dineshannayya/yifive_r0/signoff/glbl_cfg/final_summary_report.csv

 | design | design_name | config | flow_status | total_runtime | routed_runtime | (Cell/mm^2)/Core_Util | DIEAREA_mm^2 | CellPer_mm^2 | OpenDP_Util | Peak_Memory_Usage_MB | cell_count | tritonRoute_violations | Short_violations | MetSpc_violations | OffGrid_violations | MinHole_violations | Other_violations | Magic_violations | antenna_violations | lvs_total_errors | cvc_total_errors | klayout_violations | wire_length | vias | wns | pl_wns | optimized_wns | fastroute_wns | spef_wns | tns | pl_tns | optimized_tns | fastroute_tns | spef_tns | HPWL | routing_layer1_pct | routing_layer2_pct | routing_layer3_pct | routing_layer4_pct | routing_layer5_pct | routing_layer6_pct | wires_count | wire_bits | public_wires_count | public_wire_bits | memories_count | memory_bits | processes_count | cells_pre_abc | AND | DFF | NAND | NOR | OR | XOR | XNOR | MUX | inputs
0 | /project/openlane/glbl_cfg | glbl_cfg | glbl_cfg | flow_completed | 0h8m42s | -1 | 60666.66666666667 | 0.105 | 30333.333333333336 | 37.21 | 616.23 | 3185 | 0 | 0 | 0 | 0 | 0 | 0 | 0 | 1 | 0 | -1 | -1 | 218659 | 34566 | 0.0 | -0.95 | -1 | 0.0 | -1 | 0.0 | -482.9 | -1 | 0.0 | -1 | 130990511.0 | 0.6 | 52.03 | 38.6 | 16.27 | 0.76 | -1 | 1950 | 3987 | 521 | 2526 | 0 | 0 | 0 | 2136 | 0 | 0 | 0 | 0 | 0 | 0 | 0 | 4 | 772
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
