dineshannayya/yifive_r0/signoff/mbist/final_summary_report.csv

 | design | design_name | config | flow_status | total_runtime | routed_runtime | (Cell/mm^2)/Core_Util | DIEAREA_mm^2 | CellPer_mm^2 | OpenDP_Util | Peak_Memory_Usage_MB | cell_count | tritonRoute_violations | Short_violations | MetSpc_violations | OffGrid_violations | MinHole_violations | Other_violations | Magic_violations | antenna_violations | lvs_total_errors | cvc_total_errors | klayout_violations | wire_length | vias | wns | pl_wns | optimized_wns | fastroute_wns | spef_wns | tns | pl_tns | optimized_tns | fastroute_tns | spef_tns | HPWL | routing_layer1_pct | routing_layer2_pct | routing_layer3_pct | routing_layer4_pct | routing_layer5_pct | routing_layer6_pct | wires_count | wire_bits | public_wires_count | public_wire_bits | memories_count | memory_bits | processes_count | cells_pre_abc | AND | DFF | NAND | NOR | OR | XOR | XNOR | MUX | inputs
0 | /project/openlane/mbist | mbist_top | mbist | flow_completed | 0h11m7s | -1 | 20833.333333333336 | 0.3 | 10416.666666666668 | 13.1 | 672.64 | 3125 | 0 | 0 | 0 | 0 | 0 | 0 | 0 | 10 | 0 | 0 | -1 | 458568 | 43437 | -0.67 | -6.26 | -1 | -1.39 | -1 | -0.67 | -3033.14 | -1 | -1.39 | -1 | 372704250.0 | 1.47 | 48.85 | 12.24 | 20.92 | 0.0 | -1 | 2382 | 6613 | 753 | 4936 | 0 | 0 | 0 | 2339 | 0 | 0 | 0 | 0 | 0 | 0 | 0 | 4 | 849
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
