dineshannayya/yifive_r0/signoff/sdram/final_summary_report.csv

 | design | design_name | config | flow_status | total_runtime | routed_runtime | (Cell/mm^2)/Core_Util | DIEAREA_mm^2 | CellPer_mm^2 | OpenDP_Util | Peak_Memory_Usage_MB | cell_count | tritonRoute_violations | Short_violations | MetSpc_violations | OffGrid_violations | MinHole_violations | Other_violations | Magic_violations | antenna_violations | lvs_total_errors | cvc_total_errors | klayout_violations | wire_length | vias | wns | pl_wns | optimized_wns | fastroute_wns | spef_wns | tns | pl_tns | optimized_tns | fastroute_tns | spef_tns | HPWL | routing_layer1_pct | routing_layer2_pct | routing_layer3_pct | routing_layer4_pct | routing_layer5_pct | routing_layer6_pct | wires_count | wire_bits | public_wires_count | public_wire_bits | memories_count | memory_bits | processes_count | cells_pre_abc | AND | DFF | NAND | NOR | OR | XOR | XNOR | MUX | inputs
0 | /project/openlane/sdram | sdrc_top | sdram | flow_completed | 0h8m57s | -1 | 58833.33333333334 | 0.18 | 29416.66666666667 | 38.39 | 652.09 | 5295 | 0 | 0 | 0 | 0 | 0 | 0 | 0 | 1 | 0 | -1 | -1 | 264511 | 52608 | 0.0 | 0.0 | -1 | 0.0 | -1 | 0.0 | 0.0 | -1 | 0.0 | -1 | 181294869.0 | 11.7 | 40.27 | 30.17 | 2.01 | 0.34 | -1 | 3629 | 7296 | 841 | 4469 | 0 | 0 | 0 | 4426 | 0 | 0 | 0 | 0 | 0 | 0 | 0 | 4 | 1522
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
