dineshannayya/yifive_r0/signoff/spi_master/final_summary_report.csv

 | design | design_name | config | flow_status | total_runtime | routed_runtime | (Cell/mm^2)/Core_Util | DIEAREA_mm^2 | CellPer_mm^2 | OpenDP_Util | Peak_Memory_Usage_MB | cell_count | tritonRoute_violations | Short_violations | MetSpc_violations | OffGrid_violations | MinHole_violations | Other_violations | Magic_violations | antenna_violations | lvs_total_errors | cvc_total_errors | klayout_violations | wire_length | vias | wns | pl_wns | optimized_wns | fastroute_wns | spef_wns | tns | pl_tns | optimized_tns | fastroute_tns | spef_tns | HPWL | routing_layer1_pct | routing_layer2_pct | routing_layer3_pct | routing_layer4_pct | routing_layer5_pct | routing_layer6_pct | wires_count | wire_bits | public_wires_count | public_wire_bits | memories_count | memory_bits | processes_count | cells_pre_abc | AND | DFF | NAND | NOR | OR | XOR | XNOR | MUX | inputs
0 | /project/openlane/spi_master | spim_top | spi_master | flow_completed | 0h10m43s | -1 | 64763.63636363637 | 0.22 | 32381.818181818184 | 37.62 | 697.03 | 7124 | 0 | 0 | 0 | 0 | 0 | 0 | 0 | 1 | 0 | -1 | -1 | 300310 | 62802 | 0.0 | -4.46 | -1 | 0.0 | -1 | 0.0 | -1730.99 | -1 | 0.0 | -1 | 205930279.0 | 6.93 | 34.26 | 32.3 | 0.58 | 1.13 | -1 | 5865 | 8818 | 529 | 3481 | 0 | 0 | 0 | 6881 | 0 | 0 | 0 | 0 | 0 | 0 | 0 | 4 | 1764
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
