dineshannayya/yifive_r0/signoff/syntacore/final_summary_report.csv

 | design | design_name | config | flow_status | total_runtime | routed_runtime | (Cell/mm^2)/Core_Util | DIEAREA_mm^2 | CellPer_mm^2 | OpenDP_Util | Peak_Memory_Usage_MB | cell_count | tritonRoute_violations | Short_violations | MetSpc_violations | OffGrid_violations | MinHole_violations | Other_violations | Magic_violations | antenna_violations | lvs_total_errors | cvc_total_errors | klayout_violations | wire_length | vias | wns | pl_wns | optimized_wns | fastroute_wns | spef_wns | tns | pl_tns | optimized_tns | fastroute_tns | spef_tns | HPWL | routing_layer1_pct | routing_layer2_pct | routing_layer3_pct | routing_layer4_pct | routing_layer5_pct | routing_layer6_pct | wires_count | wire_bits | public_wires_count | public_wire_bits | memories_count | memory_bits | processes_count | cells_pre_abc | AND | DFF | NAND | NOR | OR | XOR | XNOR | MUX | inputs
0 | /project/openlane/syntacore | scr1_top_wb | syntacore | flow_completed | 0h50m54s | -1 | 53830.971659919036 | 0.7904 | 26915.485829959518 | 30.93 | 1194.42 | 21274 | 0 | -1 | -1 | -1 | -1 | 0 | -1 | 1 | 0 | -1 | -1 | 1674760 | 240681 | -2.04 | -17.8 | -1 | 0.0 | -1 | -2459.49 | -21655.63 | -1 | 0.0 | -1 | 1322263875.0 | 0.0 | 62.03 | 24.69 | 26.16 | 0.01 | -1 | 18597 | 30067 | 1067 | 12430 | 0 | 0 | 0 | 21980 | 0 | 0 | 0 | 0 | 0 | 0 | 0 | 4 | 5240
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
