dineshannayya/yifive_r0/signoff/uart_i2cm_usb/final_summary_report.csv

 | design | design_name | config | flow_status | total_runtime | routed_runtime | (Cell/mm^2)/Core_Util | DIEAREA_mm^2 | CellPer_mm^2 | OpenDP_Util | Peak_Memory_Usage_MB | cell_count | tritonRoute_violations | Short_violations | MetSpc_violations | OffGrid_violations | MinHole_violations | Other_violations | Magic_violations | antenna_violations | lvs_total_errors | cvc_total_errors | klayout_violations | wire_length | vias | wns | pl_wns | optimized_wns | fastroute_wns | spef_wns | tns | pl_tns | optimized_tns | fastroute_tns | spef_tns | HPWL | routing_layer1_pct | routing_layer2_pct | routing_layer3_pct | routing_layer4_pct | routing_layer5_pct | routing_layer6_pct | wires_count | wire_bits | public_wires_count | public_wire_bits | memories_count | memory_bits | processes_count | cells_pre_abc | AND | DFF | NAND | NOR | OR | XOR | XNOR | MUX | inputs
0 | /project/openlane/uart_i2cm_usb | uart_i2c_usb_top | uart_i2cm_usb | flow_completed | 0h14m13s | -1 | 74885.71428571428 | 0.28 | 37442.85714285714 | 43.47 | 782.88 | 10484 | 0 | 0 | 0 | 0 | 0 | 0 | 0 | 1 | 0 | -1 | -1 | 401689 | 90516 | -3.8 | -4.1 | -1 | -4.03 | -1 | -3.8 | -4.1 | -1 | -4.03 | -1 | 247493303.0 | 9.32 | 33.09 | 35.78 | 0.5 | 1.33 | -1 | 7738 | 11501 | 1123 | 4829 | 0 | 0 | 0 | 9082 | 0 | 0 | 0 | 0 | 0 | 0 | 0 | 4 | 2495
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
