dineshannayya/yifive_r0/signoff/user_project_wrapper/final_summary_report.csv

 | design | design_name | config | flow_status | total_runtime | routed_runtime | (Cell/mm^2)/Core_Util | DIEAREA_mm^2 | CellPer_mm^2 | OpenDP_Util | Peak_Memory_Usage_MB | cell_count | tritonRoute_violations | Short_violations | MetSpc_violations | OffGrid_violations | MinHole_violations | Other_violations | Magic_violations | antenna_violations | lvs_total_errors | cvc_total_errors | klayout_violations | wire_length | vias | wns | pl_wns | optimized_wns | fastroute_wns | spef_wns | tns | pl_tns | optimized_tns | fastroute_tns | spef_tns | HPWL | routing_layer1_pct | routing_layer2_pct | routing_layer3_pct | routing_layer4_pct | routing_layer5_pct | routing_layer6_pct | wires_count | wire_bits | public_wires_count | public_wire_bits | memories_count | memory_bits | processes_count | cells_pre_abc | AND | DFF | NAND | NOR | OR | XOR | XNOR | MUX | inputs
0 | /project/openlane/user_project_wrapper | user_project_wrapper | user_project_wrapper | flow_completed | 0h46m4s | -1 | 2.724159402241594 | 10.2784 | 1.362079701120797 | -1 | 534.94 | 14 | 0 | 0 | 0 | 0 | 0 | 0 | -1 | 0 | 0 | -1 | -1 | 1197869 | 8985 | 0.0 | -1 | -1 | 0.0 | -1 | 0.0 | -1 | -1 | 0.0 | -1 | -1 | 40144.17 | 3.22 | 3.61 | 0.52 | 0.31 | -1 | 248 | 2587 | 248 | 2587 | 0 | 0 | 0 | 14 | 0 | 0 | 0 | 0 | 0 | 0 | 0 | 0 | -1
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
