dineshannayya/yifive_r0/signoff/wb_host/final_summary_report.csv

 | design | design_name | config | flow_status | total_runtime | routed_runtime | (Cell/mm^2)/Core_Util | DIEAREA_mm^2 | CellPer_mm^2 | OpenDP_Util | Peak_Memory_Usage_MB | cell_count | tritonRoute_violations | Short_violations | MetSpc_violations | OffGrid_violations | MinHole_violations | Other_violations | Magic_violations | antenna_violations | lvs_total_errors | cvc_total_errors | klayout_violations | wire_length | vias | wns | pl_wns | optimized_wns | fastroute_wns | spef_wns | tns | pl_tns | optimized_tns | fastroute_tns | spef_tns | HPWL | routing_layer1_pct | routing_layer2_pct | routing_layer3_pct | routing_layer4_pct | routing_layer5_pct | routing_layer6_pct | wires_count | wire_bits | public_wires_count | public_wire_bits | memories_count | memory_bits | processes_count | cells_pre_abc | AND | DFF | NAND | NOR | OR | XOR | XNOR | MUX | inputs
0 | /project/openlane/wb_host | wb_host | wb_host | flow_completed | 0h6m24s | -1 | 49800.0 | 0.09 | 24900.0 | 36.04 | 609.64 | 2241 | 0 | -1 | -1 | -1 | -1 | 0 | 0 | -1 | 0 | -1 | -1 | 158094 | 26135 | 0.0 | 0.0 | -1 | -0.09 | -1 | 0.0 | 0.0 | -1 | -0.09 | -1 | 112927130.0 | 0.0 | 47.24 | 28.68 | 12.14 | 0.68 | -1 | 1599 | 3229 | 899 | 2527 | 0 | 0 | 0 | 1469 | 0 | 0 | 0 | 0 | 0 | 0 | 0 | 4 | 796
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
