dineshannayya/yifive_r0/signoff/wb_interconnect/final_summary_report.csv

 | design | design_name | config | flow_status | total_runtime | routed_runtime | (Cell/mm^2)/Core_Util | DIEAREA_mm^2 | CellPer_mm^2 | OpenDP_Util | Peak_Memory_Usage_MB | cell_count | tritonRoute_violations | Short_violations | MetSpc_violations | OffGrid_violations | MinHole_violations | Other_violations | Magic_violations | antenna_violations | lvs_total_errors | cvc_total_errors | klayout_violations | wire_length | vias | wns | pl_wns | optimized_wns | fastroute_wns | spef_wns | tns | pl_tns | optimized_tns | fastroute_tns | spef_tns | HPWL | routing_layer1_pct | routing_layer2_pct | routing_layer3_pct | routing_layer4_pct | routing_layer5_pct | routing_layer6_pct | wires_count | wire_bits | public_wires_count | public_wire_bits | memories_count | memory_bits | processes_count | cells_pre_abc | AND | DFF | NAND | NOR | OR | XOR | XNOR | MUX | inputs
0 | /project/openlane/wb_interconnect | wb_interconnect | wb_interconnect | flow_completed | 0h12m52s | -1 | 12107.954545454546 | 0.35200000000000004 | 6053.977272727273 | 4.61 | 686.9 | 2131 | 0 | -1 | -1 | -1 | -1 | 0 | -1 | 1 | 0 | -1 | -1 | 663353 | 31446 | -1.43 | -1.45 | -1 | -1.64 | -1 | -1.43 | -1.45 | -1 | -2.21 | -1 | 563613963.0 | 42.91 | 16.69 | 51.52 | 3.4 | 37.15 | -1 | 1061 | 3394 | 188 | 2521 | 0 | 0 | 0 | 1418 | 0 | 0 | 0 | 0 | 0 | 0 | 0 | 4 | 475
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
