dineshannayya/yifive_r0/verilog/dv/user_mbist_test1/user_mbist_test1_tb.v

////////////////////////////////////////////////////////////////////////////
// SPDX-FileCopyrightText:  2021 , Dinesh Annayya
//
// Licensed under the Apache License, Version 2.0 (the "License");
// you may not use this file except in compliance with the License.
// You may obtain a copy of the License at
//
//      http://www.apache.org/licenses/LICENSE-2.0
//
// Unless required by applicable law or agreed to in writing, software
// distributed under the License is distributed on an "AS IS" BASIS,
// WITHOUT WARRANTIES OR CONDITIONS OF ANY KIND, either express or implied.
// See the License for the specific language governing permissions and
// limitations under the License.
// SPDX-License-Identifier: Apache-2.0
// SPDX-FileContributor: Modified by Dinesh Annayya <dinesha@opencores.org>
//////////////////////////////////////////////////////////////////////
////                                                              ////
////  Standalone User validation Test bench                       ////
////                                                              ////
////                                                              ////
////  Description                                                 ////
////   This is a standalone test bench to validate the            ////
////   Digital core MBIST logic through External WB i/F.          ////
////                                                              ////
////  To Do:                                                      ////
////    nothing                                                   ////
////                                                              ////
////  Author(s):                                                  ////
////      - Dinesh Annayya, dinesha@opencores.org                 ////
////                                                              ////
////  Revision :                                                  ////
////    0.1 - 18 Oct 2021, Dinesh A                               ////
////                                                              ////
//////////////////////////////////////////////////////////////////////

`default_nettype wire

`timescale 1 ns / 1 ns

`include "uprj_netlists.v"

`define WB_MAP           `30080_0000
`define GLBL_FUNC_MAP    'h3002_0000
`define MBIST1_FUNC_MAP  'h3003_0000  // 0x3003_0000 to 0x3003_07FF
`define MBIST2_FUNC_MAP  'h3003_0800  // 0x3003_0800 to 0x3003_0FFF
`define MBIST3_FUNC_MAP  'h3003_1000  // 0x3003_1000 to 0x3003_17FF
`define MBIST4_FUNC_MAP  'h3003_1800  // 0x3003_1800 to 0x3003_1FFF

`define GLBL_BIST_CTRL1  'h3002_0040    
`define GLBL_BIST_STAT1  'h3002_0044
`define GLBL_BIST_SWDATA 'h3002_0048
`define GLBL_BIST_SRDATA 'h3002_004C
`define GLBL_BIST_SPDATA 'h3002_0048  #

`define WB_GLBL_CTRL     'h3080_0000

`define NO_SRAM          4 // 8



module user_mbist_test1_tb;
	reg clock;
	reg wb_rst_i;
	reg power1, power2;
	reg power3, power4;

        reg        wbd_ext_cyc_i;  // strobe/request
        reg        wbd_ext_stb_i;  // strobe/request
        reg [31:0] wbd_ext_adr_i;  // address
        reg        wbd_ext_we_i;  // write
        reg [31:0] wbd_ext_dat_i;  // data output
        reg [3:0]  wbd_ext_sel_i;  // byte enable

        wire [31:0] wbd_ext_dat_o;  // data input
        wire        wbd_ext_ack_o;  // acknowlegement
        wire        wbd_ext_err_o;  // error

	// User I/O
	wire [37:0] io_oeb;
	wire [37:0] io_out;
	wire [37:0] io_in;

	wire gpio;
	wire [37:0] mprj_io;
	wire [7:0] mprj_io_0;
	reg        test_fail;
	reg [31:0] read_data;
        reg [31:0] writemem [0:511];
        reg [8:0]  faultaddr [0:7];
        integer i;
        event      error_insert;


	// External clock is used by default.  Make this artificially fast for the
	// simulation.  Normally this would be a slow clock and the digital PLL
	// would be the fast clock.

	always #12.5 clock <= (clock === 1'b0);

	initial begin
		clock = 0;
                wbd_ext_cyc_i ='h0;  // strobe/request
                wbd_ext_stb_i ='h0;  // strobe/request
                wbd_ext_adr_i ='h0;  // address
                wbd_ext_we_i  ='h0;  // write
                wbd_ext_dat_i ='h0;  // data output
                wbd_ext_sel_i ='h0;  // byte enable
	end

	`ifdef WFDUMP
	   initial begin
	   	$dumpfile("simx.vcd");
	   	$dumpvars(2, user_mbist_test1_tb);
	   	$dumpvars(0, user_mbist_test1_tb.u_top.u_mbist);
	   	$dumpvars(0, user_mbist_test1_tb.u_top.u_intercon);
	   	$dumpvars(0, user_mbist_test1_tb.u_top.u_glbl_cfg);
		$dumpoff;
	   end
       `endif

	initial begin
		wb_rst_i <= 1'b1;
		#100;
		wb_rst_i <= 1'b0;	    	// Release reset

		#200; // Wait for reset removal
	        repeat (10) @(posedge clock);
		$display("Monitor: Standalone User Test Started");

		test_fail = 0;
		// Remove Wb Reset
		wb_user_core_write(`WB_GLBL_CTRL,'h1);

		$dumpoff;
	    	$display("###################################################");
	    	$display(" MBIST Test with Without Address Failure");
	    	$display("###################################################");

		// Check Is there is any BIST Error
		// [0]   - Bist Done      - 1
		// [1]   - Bist Error     - 0
		// [2]   - Bist Correct   - 0
		// [3]   - Reserved       - 0
		// [7:4] - Bist Error Cnt - 4'h0
		insert_fault(0,0,0,0,0,32'h01010101);

          	if(test_fail == 0) begin
	    	    $display("Monitor: Step-1: BIST Test without any Memory Error insertion test Passed");
	        end else begin
	    	    $display("Monitor: Step-1: BIST Test without any Memory Error insertion test Failed");
		end
	    	$display("###################################################");
	    	
		$display("#########################################################");
	    	$display(" MBIST Test with With Single Address Failure for MEM-0");
	    	$display("#########################################################");

		// Check Is there is any BIST Error
		// [0]   - Bist Done      - 1
		// [1]   - Bist Error     - 0
		// [2]   - Bist Correct   - 1
		// [3]   - Reserved       - 0
		// [7:4] - Bist Error Cnt - 4'h1
		faultaddr[0] = 9'h10;
		faultaddr[1] = 9'h20;
		faultaddr[2] = 9'h30;
		faultaddr[3] = 9'h40;
		insert_fault(1,0,0,0,0,32'h01010115);

          	if(test_fail == 0) begin
	    	    $display("Monitor: Step-2.1: BIST Test with Single Address Failure at MEM0 Error insertion test Passed");
	        end else begin
	    	    $display("Monitor: Step-2.1: BIST Test with Single Address Failure at MEM0 Error insertion test Failed");
		end
		$display("##########################################################");
	    	$display(" MBIST Test with With Single Address Failure for MEM-0/1");
	    	$display("##########################################################");

		// Check Is there is any BIST Error
		// [0]   - Bist Done      - 1
		// [1]   - Bist Error     - 0
		// [2]   - Bist Correct   - 1
		// [3]   - Reserved       - 0
		// [7:4] - Bist Error Cnt - 4'h1
		faultaddr[0] = 9'h10;
		faultaddr[1] = 9'h20;
		faultaddr[2] = 9'h30;
		faultaddr[3] = 9'h40;
		insert_fault(1,1,0,0,0,32'h01011515);

          	if(test_fail == 0) begin
	    	    $display("Monitor: Step-2.2: BIST Test with Single Address Failure at MEM0/1 Error insertion test Passed");
	        end else begin
	    	    $display("Monitor: Step-2.2: BIST Test with Single Address Failure at MEM0/1 Error insertion test Failed");
		end
		$display("##########################################################");
	    	$display(" MBIST Test with With Single Address Failure for MEM-0/1/2");
	    	$display("##########################################################");

		// Check Is there is any BIST Error
		// [0]   - Bist Done      - 1
		// [1]   - Bist Error     - 0
		// [2]   - Bist Correct   - 1
		// [3]   - Reserved       - 0
		// [7:4] - Bist Error Cnt - 4'h1
		faultaddr[0] = 9'h10;
		faultaddr[1] = 9'h20;
		faultaddr[2] = 9'h30;
		faultaddr[3] = 9'h40;
		insert_fault(1,1,1,0,0,32'h01151515);

          	if(test_fail == 0) begin
	    	    $display("Monitor: Step-2.3: BIST Test with Single Address Failure at MEM0/1/2 Error insertion test Passed");
	        end else begin
	    	    $display("Monitor: Step-2.3: BIST Test with Single Address Failure at MEM0/1/2 Error insertion test Failed");
		end

		$dumpon;
	    	$display("###################################################");
	    	$display(" MBIST Test with Single Address Failure to All Memory");
	    	$display("###################################################");
		   // Check Is there is any BIST Error
		   // [0]   - Bist Done      - 1
		   // [1]   - Bist Error     - 0
		   // [2]   - Bist Correct   - 1
		   // [3]   - Reserved       - 0
		   // [7:4] - Bist Error Cnt - 4'h1
		   //if(read_data[6:0]  != 7'b0001101) test_fail = 1; // Bist correct = 1 and Bist Err Cnt - 0x1
		faultaddr[0] = 9'h10;
		faultaddr[1] = 9'h20;
		faultaddr[2] = 9'h30;
		faultaddr[3] = 9'h40;
		insert_fault(1,1,1,1,1,32'h15151515);

          	if(test_fail == 0) begin
	    	    $display("Monitor: Step-2.4: BIST Test with One Memory Error insertion test Passed");
	        end else begin
	    	    $display("Monitor: Step-2.4: BIST Test with One Memory Error insertion test Failed");
		end
	    	$display("###################################################");

		$display("#########################################################");
	    	$display(" MBIST Test with With Two Address Failure for MEM-0");
	    	$display("#########################################################");

		// Check Is there is any BIST Error
		// [0]   - Bist Done      - 1
		// [1]   - Bist Error     - 0
		// [2]   - Bist Correct   - 1
		// [3]   - Reserved       - 0
		// [7:4] - Bist Error Cnt - 4'h2
		faultaddr[0] = 9'h10;
		faultaddr[1] = 9'h20;
		faultaddr[2] = 9'h30;
		faultaddr[3] = 9'h40;
		insert_fault(2,0,0,0,0,32'h01010125);

          	if(test_fail == 0) begin
	    	    $display("Monitor: Step-3.1: BIST Test with Two Address Failure at MEM0 Error insertion test Passed");
	        end else begin
	    	    $display("Monitor: Step-3.1: BIST Test with Two Address Failure at MEM0 Error insertion test Failed");
		end
		$display("##########################################################");
	    	$display(" MBIST Test with With Two Address Failure for MEM-0/1");
	    	$display("##########################################################");

		// Check Is there is any BIST Error
		// [0]   - Bist Done      - 1
		// [1]   - Bist Error     - 0
		// [2]   - Bist Correct   - 1
		// [3]   - Reserved       - 0
		// [7:4] - Bist Error Cnt - 4'h2
		faultaddr[0] = 9'h10;
		faultaddr[1] = 9'h20;
		faultaddr[2] = 9'h30;
		faultaddr[3] = 9'h40;
		insert_fault(2,2,0,0,0,32'h01012525);

          	if(test_fail == 0) begin
	    	    $display("Monitor: Step-3.2: BIST Test with Two Address Failure at MEM0/1 Error insertion test Passed");
	        end else begin
	    	    $display("Monitor: Step-3.2: BIST Test with Two Address Failure at MEM0/1 Error insertion test Failed");
		end
		$display("##########################################################");
	    	$display(" MBIST Test with With Two Address Failure for MEM-0/1/2");
	    	$display("##########################################################");

		// Check Is there is any BIST Error
		// [0]   - Bist Done      - 1
		// [1]   - Bist Error     - 0
		// [2]   - Bist Correct   - 1
		// [3]   - Reserved       - 0
		// [7:4] - Bist Error Cnt - 4'h2
		faultaddr[0] = 9'h10;
		faultaddr[1] = 9'h20;
		faultaddr[2] = 9'h30;
		faultaddr[3] = 9'h40;
		insert_fault(2,2,2,0,0,32'h01252525);

          	if(test_fail == 0) begin
	    	    $display("Monitor: Step-3.3: BIST Test with Two Address Failure at MEM0/1/2 Error insertion test Passed");
	        end else begin
	    	    $display("Monitor: Step-3.3: BIST Test with Two Address Failure at MEM0/1/2 Error insertion test Failed");
		end
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
