dineshannayya/yifive_r0/(commit log)

2021-06-06 Initial version of efabless caravel user project
    [macro.cfg, pin_order.cfg]
2021-06-06 syntacore added
    [pin_order.cfg]
2021-06-08 spi master added
    [pin_order.cfg]
2021-06-13 sdram added
    [pin_order.cfg]
2021-06-13 pin order update for sdram & syntacore
    [pin_order.cfg]
2021-06-14 Read me update with Soc Pin Map
2021-06-14 signoff added
    [final_summary_report.csv]
2021-06-17 spi rtl issue fix in clkgen
2021-06-18 first user project lvs clean database
    [final_summary_report.csv, macro_placement.cfg, pin_order.cfg]
2021-06-18 def,lef,gds,mag,spi,magled added
2021-06-20 floor planning cleanup
    [macro_placement.cfg, pin_order.cfg]
2021-06-21 uart integrated into SOC
    [pin_order.cfg]
2021-06-21 uart test case integration
2021-06-21 def,gds,lef addition
    [final_summary_report.csv, pin_order.cfg]
2021-06-24 script update
    [final_summary_report.csv, macro_placement.cfg, pin_order.cfg]
2021-06-25 database update
    [final_summary_report.csv, macro.cfg, macro_placement.cfg, pin_order.cfg]
2021-06-25 user project def,lef,gds added
    [final_summary_report.csv]
2021-06-27 backand cleanup
    [final_summary_report.csv, macro.cfg, pin_order.cfg]
2021-06-27 wb_host rtl and openlane setup added
    [final_summary_report.csv, pin_order.cfg]
2021-06-27 updated database
    [final_summary_report.csv]
2021-06-28 DRC clean user_project_wrapper
    [final_summary_report.csv, macro.cfg, pin_order.cfg]
2021-06-28 precheck cleanup
    [final_summary_report.csv]
2021-06-30 Clock Skew adjust network added + Inside SDRAM WB Stagging FF added
    [macro.cfg, pin_order.cfg]
2021-06-30 first version of pre-check clean database
    [final_summary_report.csv]
2021-07-05 Clean GateSim and RTL Sim + Updated SPI Master
    [final_summary_report.csv, macro.cfg, pin_order.cfg]
2021-07-07 Timing Closure related clean-up. Hold fix added at spi-master and clock delay adjusted inside the clock_skew module
    [final_summary_report.csv, macro_placement.cfg, pin_order.cfg]
2021-07-07 spi unused input pin io_in[1:0] removed
    [final_summary_report.csv, pin_order.cfg]
2021-07-07 sdram clock connectivity correction at u_skew hookup
    [final_summary_report.csv]
2021-07-08 full chip sta clean-up: cpu,spi,rtc clock generation moved from glbl_cfg to wb_host
    [final_summary_report.csv, pin_order.cfg]
2021-07-10 sta clean up, global clock buf and reset buf added
    [final_summary_report.csv, macro.cfg, pin_order.cfg]
2021-07-11 clk_skew power hook fix
    [final_summary_report.csv, macro.cfg]
2021-07-12 Power Ring is now 8 + Power Mesh is 2 (vccd1 & vssd1)
    [final_summary_report.csv, pin_order.cfg]
2021-07-14 SPI Preftech logic added
    [final_summary_report.csv]
2021-07-15 syntacore timing optimization, timing stage added at scr1_pipe_mrpf
    [final_summary_report.csv]
2021-07-24 syntacore rtl changes to improve timing closure from 25Mhz to 50Mhz
    [final_summary_report.csv, pin_order.cfg]
2021-07-26 syntacore timing fix
    [final_summary_report.csv]
2021-07-27 spi master with qddr mode support added
    [final_summary_report.csv]
2021-07-28 i2cm integrated and share same uart io
    [final_summary_report.csv, macro.cfg, pin_order.cfg]
2021-07-28 YiFive Block Diagram Updated, Added I2C Master
2021-07-28 README updated with i2c info
2021-08-01 usb1 host is integrated
    [final_summary_report.csv, macro.cfg, pin_order.cfg]
2021-08-01 SPDX Non compliant text fix
    [mt48lc8m8a2.v]
2021-08-09 antenna fix
    [final_summary_report.csv]
2021-08-10 synthesis with latest yosys with $ netname avoidance fix
    [final_summary_report.csv]
2021-08-19 Riscv Unalign access fix and sdr ctrl 8 bit address mode fix
    [final_summary_report.csv]
2021-08-24 rsicv timer intr connectivity bug fix
    [final_summary_report.csv]
2021-08-27 sdram ctrl bug in for tRas Timing violation in FPGA mode, now define moved to ASIC mode
    [final_summary_report.csv]
2022-01-12 updated latest version of yifive
    [final_summary_report.csv, macro.cfg, pin_order.cfg]
